dduranovic97/HID-Foot-Mouse/Pictures/Rottary encoder with LED on.jpg

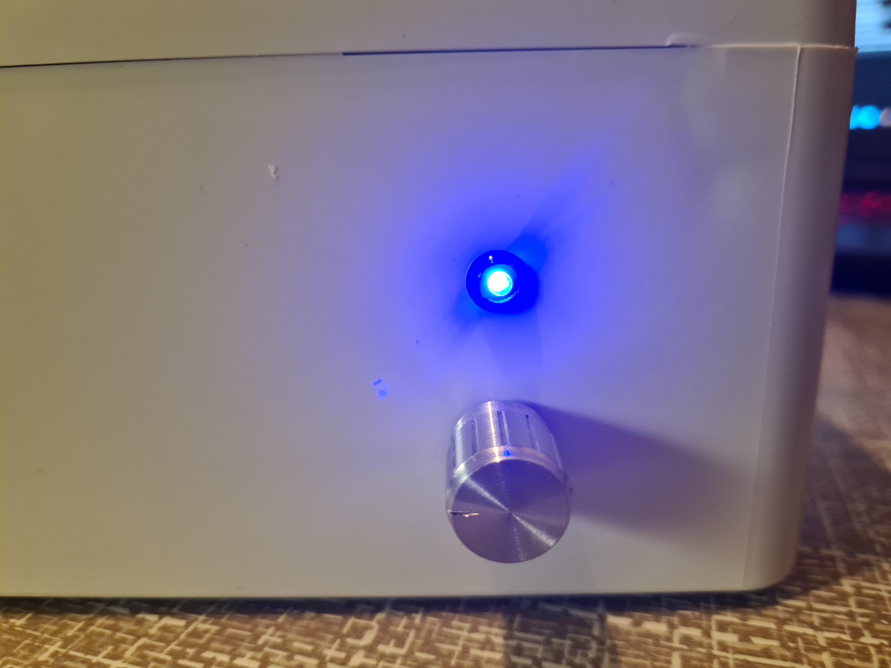
Pictures/Rottary encoder with LED on.jpg
