dduranovic97/HID-Foot-Mouse/Pictures/Rottary encoder for mouse speed control.jpg

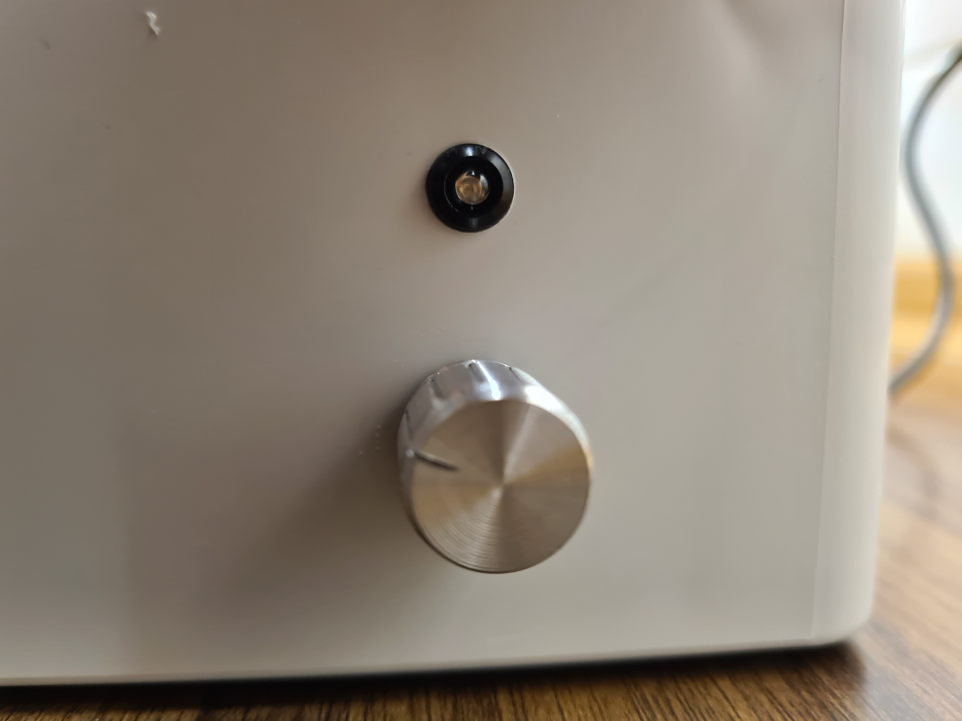
Pictures/Rottary encoder for mouse speed control.jpg
