dduranovic97/HID-Foot-Mouse/Pictures/Finished device.jpg

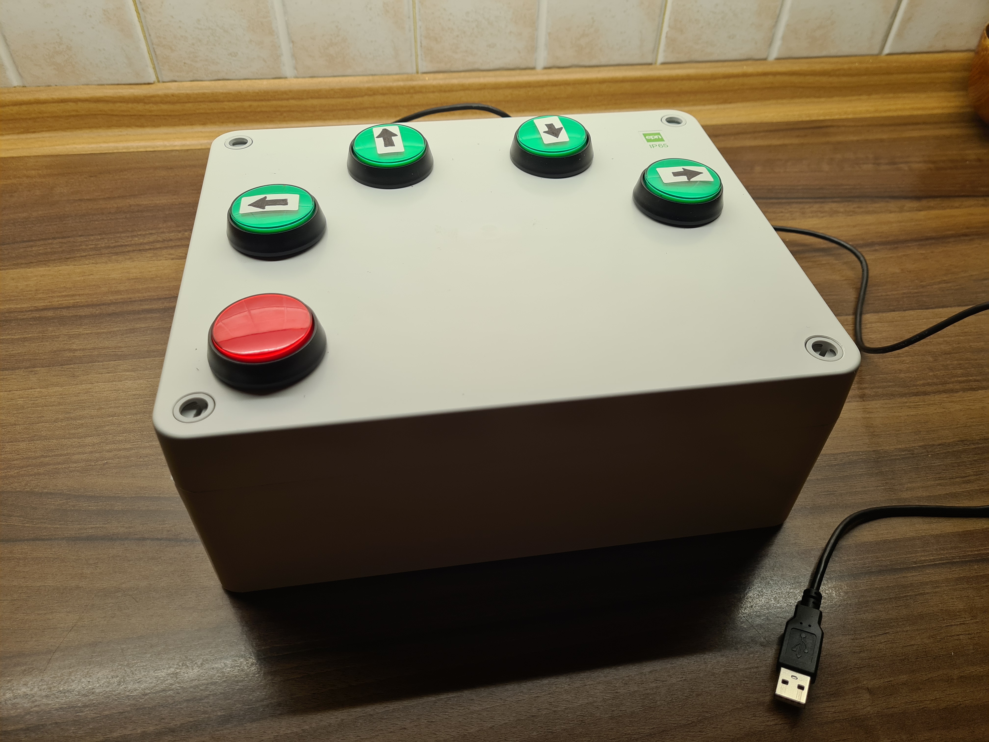
Pictures/Finished device.jpg
