dduranovic97/HID-Foot-Mouse/Pictures/Inside view.jpg

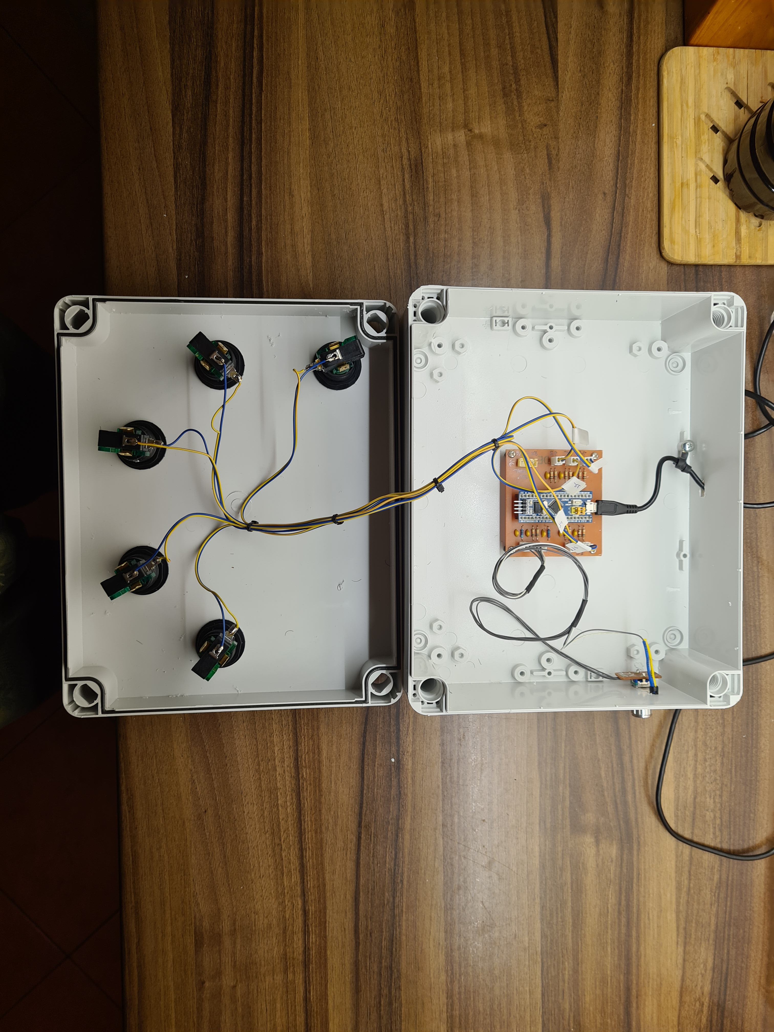
Pictures/Inside view.jpg
