dduranovic97/HID-Foot-Mouse/Pictures/Top View.jpg

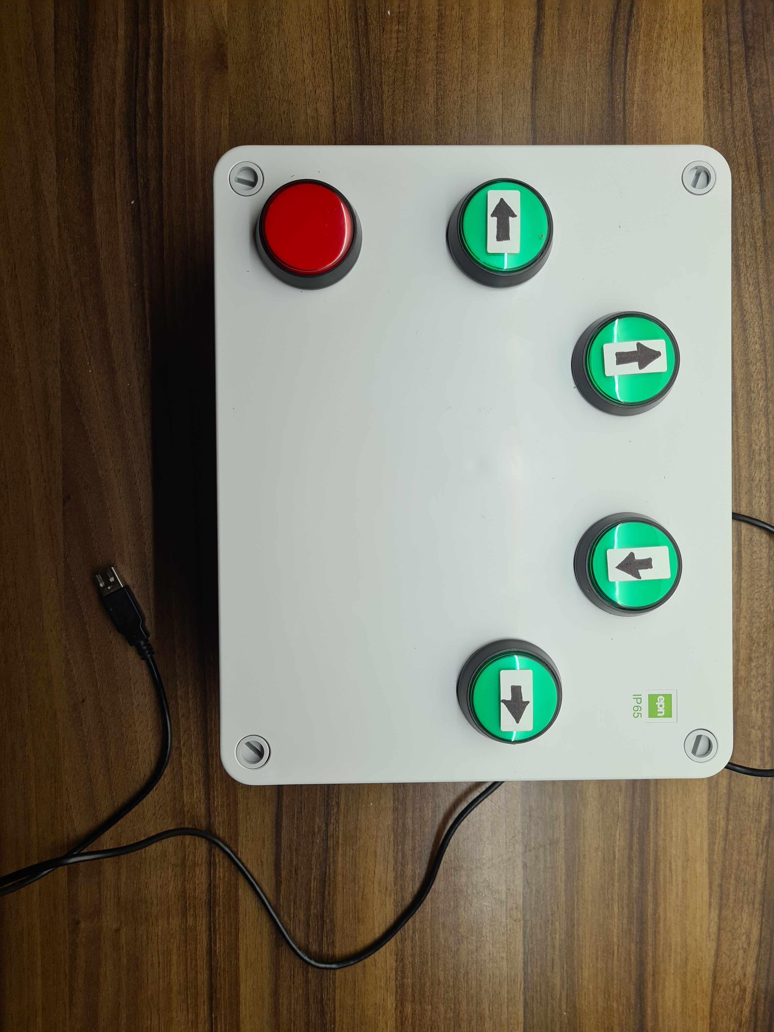
Pictures/Top View.jpg
