dduranovic97/HID-Foot-Mouse/(list of files, cad)

Other CAD files:
Housing/Foot Mouse Housing.FCStd
Housing/Foot Mouse Housing.dxf
