dduranovic97/HID-Foot-Mouse/PCB/v2/Foot_Mouse_Schematic.pdf

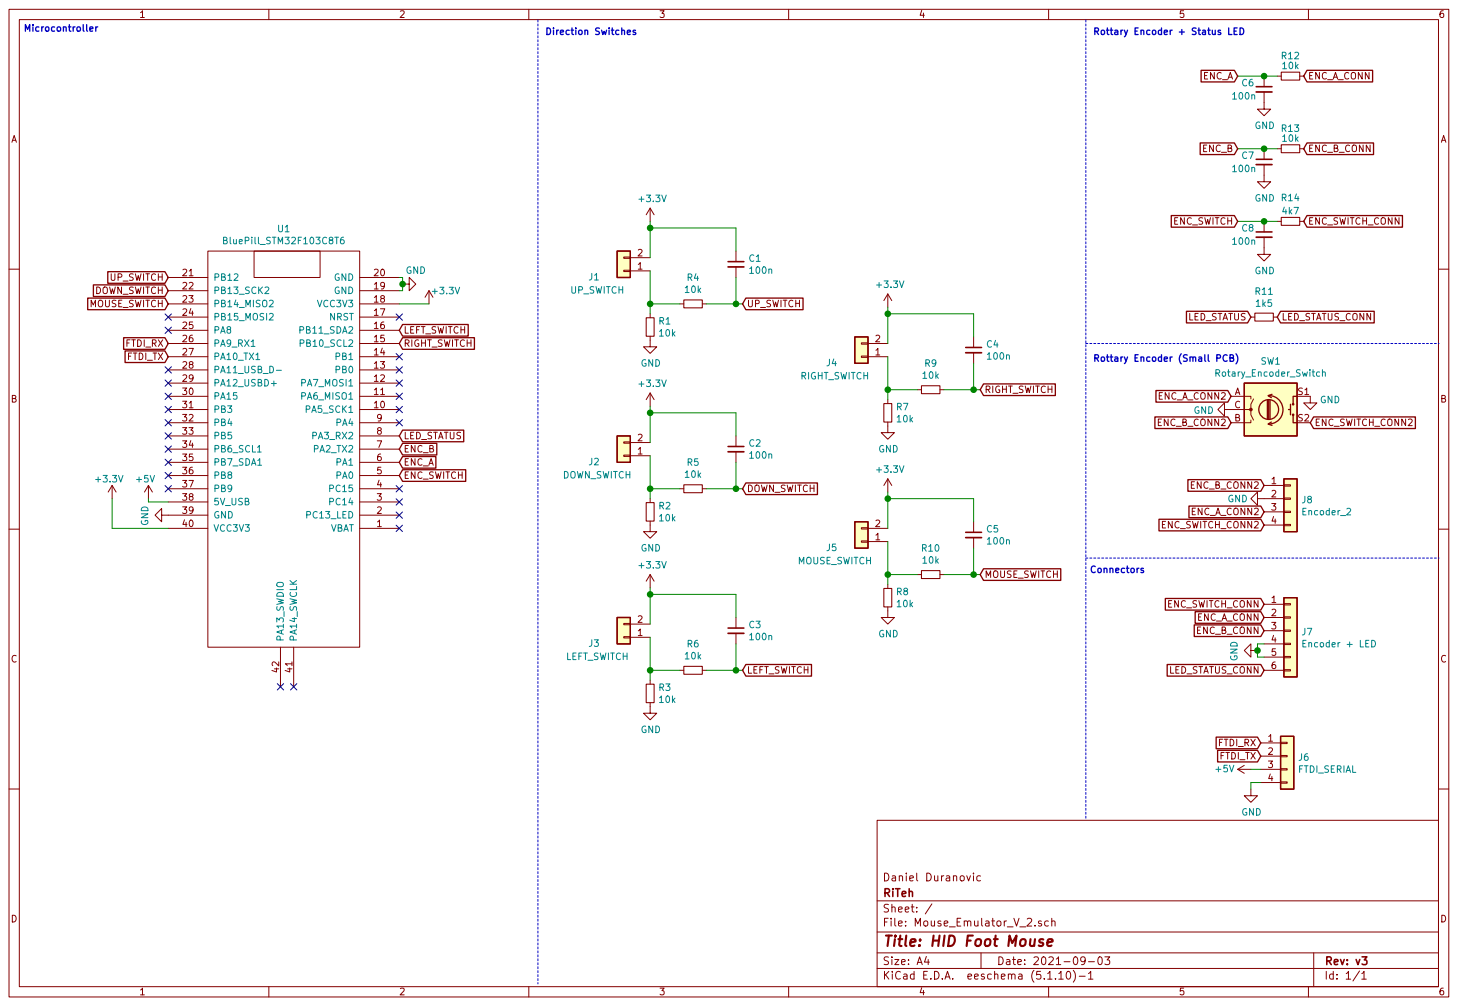
[picture p6: page 1]

File: Mouse_Emulator_V_2.sch Sheet: / RiTeh Daniel Duranovic GND

Id: 1/1 Title: HID Foot Mouse
