dduranovic97/HID-Foot-Mouse/Housing/Foot Mouse Housing.pdf

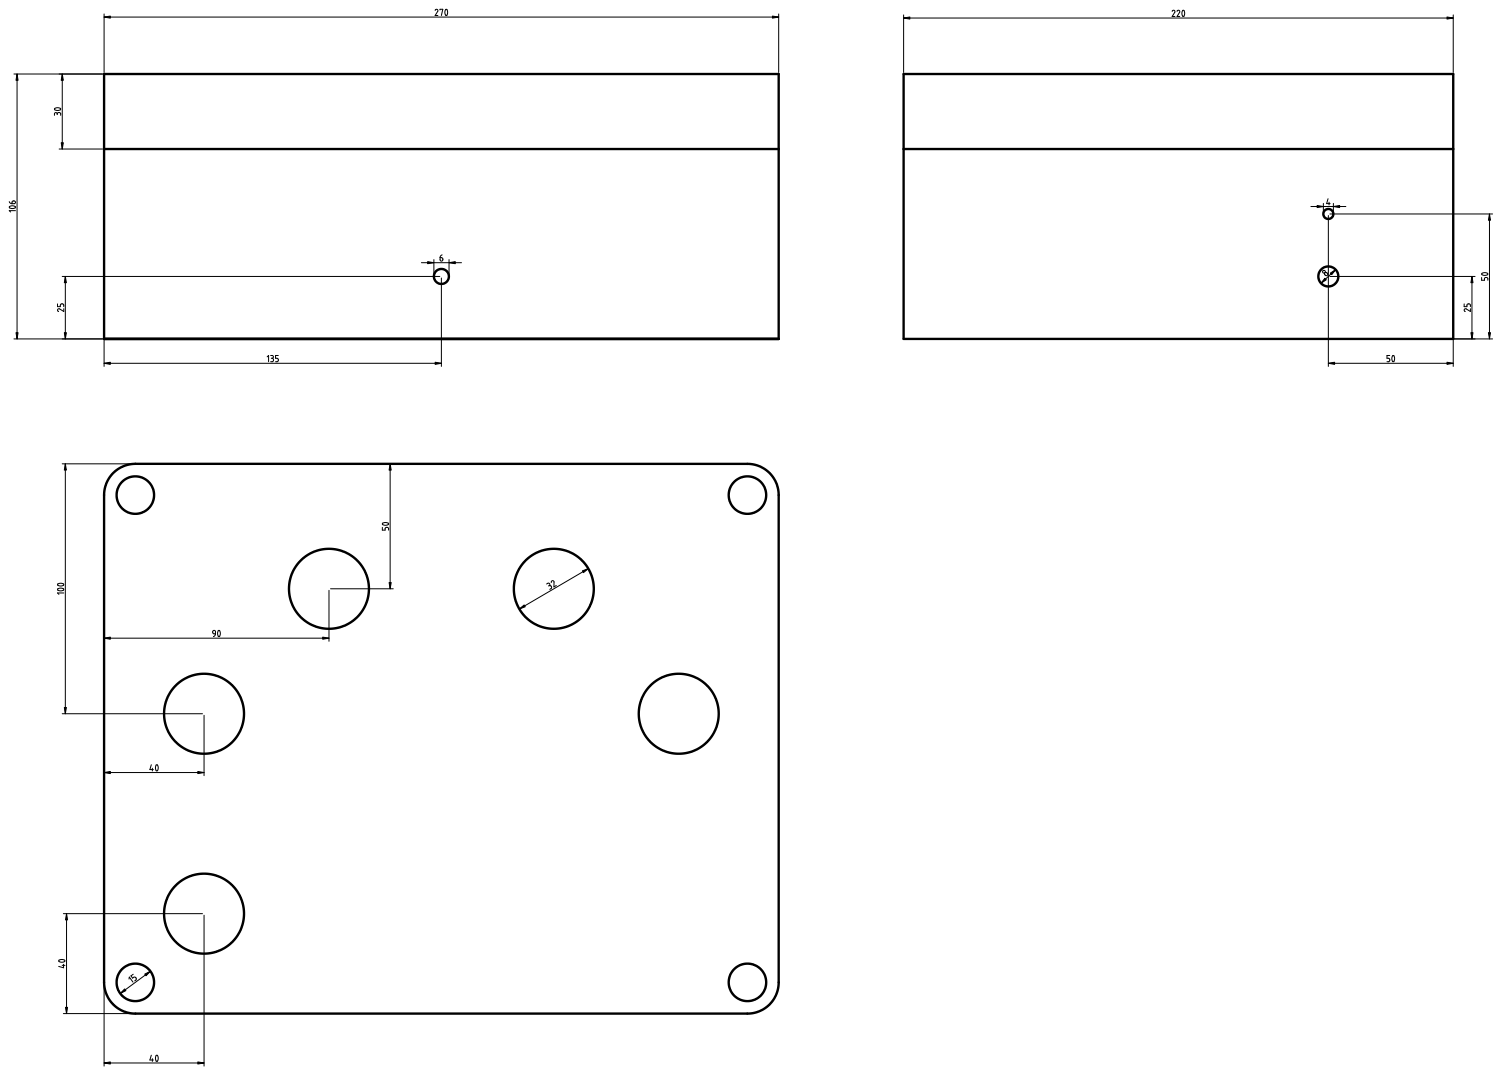
[picture p7: page 1]
