dduranovic97/HID-Foot-Mouse/PCB/v2/Foot_Mouse_PCB_Mounting.pdf

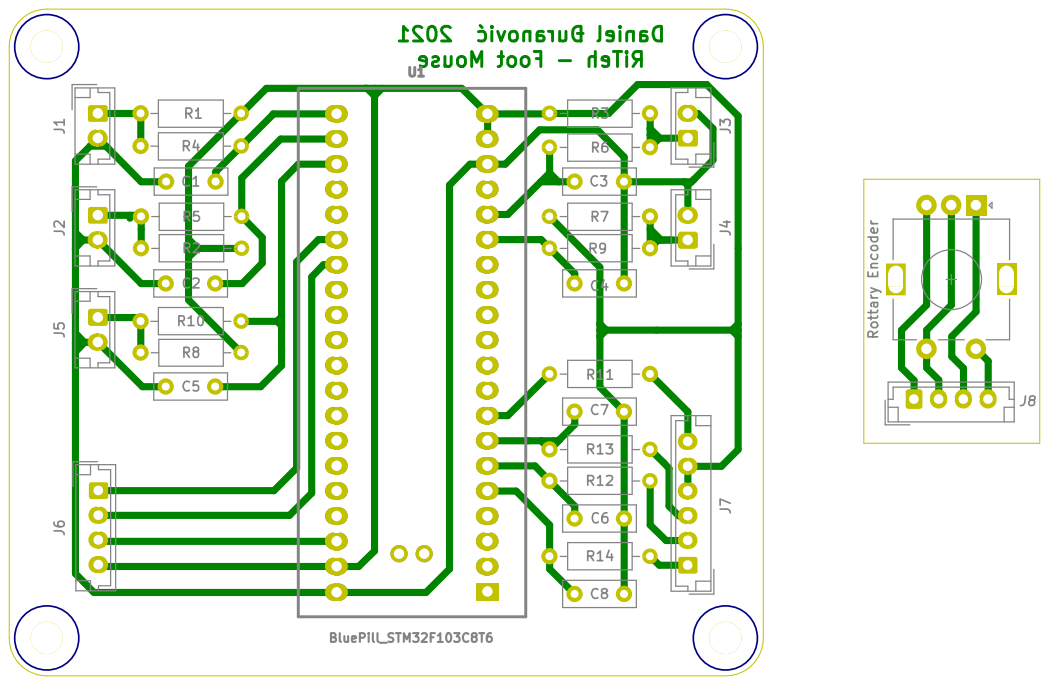
[picture p8: page 1]
