dduranovic97/HID-Foot-Mouse/PCB/v2/Foot_Mouse_PCB_Traces.pdf

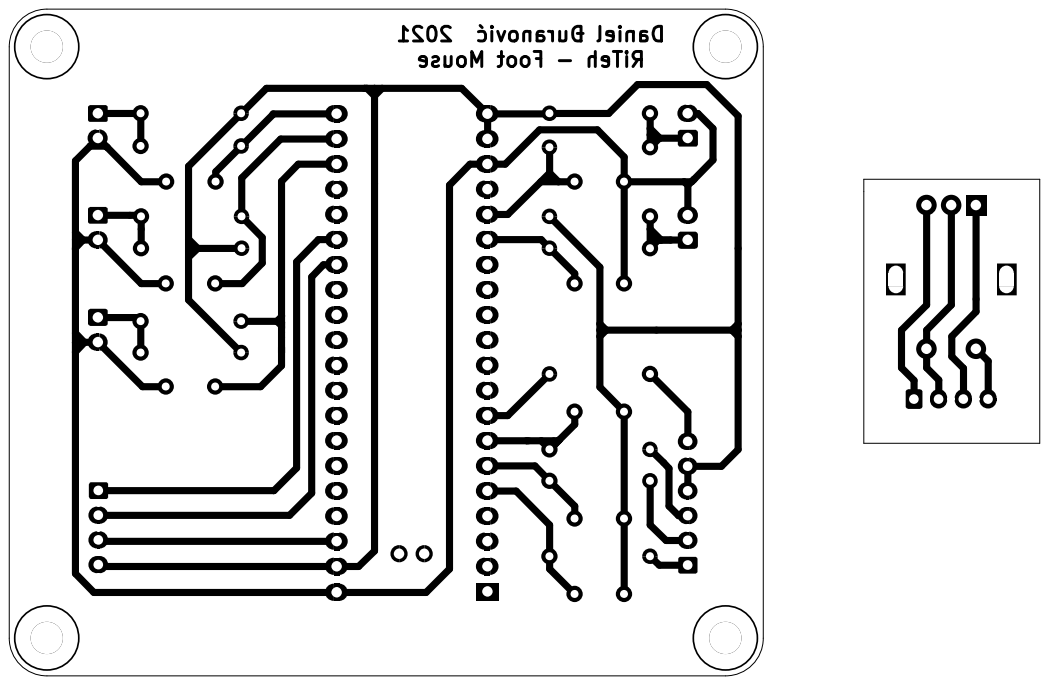
[picture p9: page 1]
