dduranovic97/HID-Foot-Mouse/(list of files, drawings)

Other design files:
PCB/v1/mouse.lay6
