dduranovic97/HID-Foot-Mouse/PCB/v2/KiCad Files/Mouse_Emulator_V_2.kicad_pcb

## KiCad design PCB/v2/KiCad Files/Mouse_Emulator_V_2.kicad_pcb (2021-09-05)

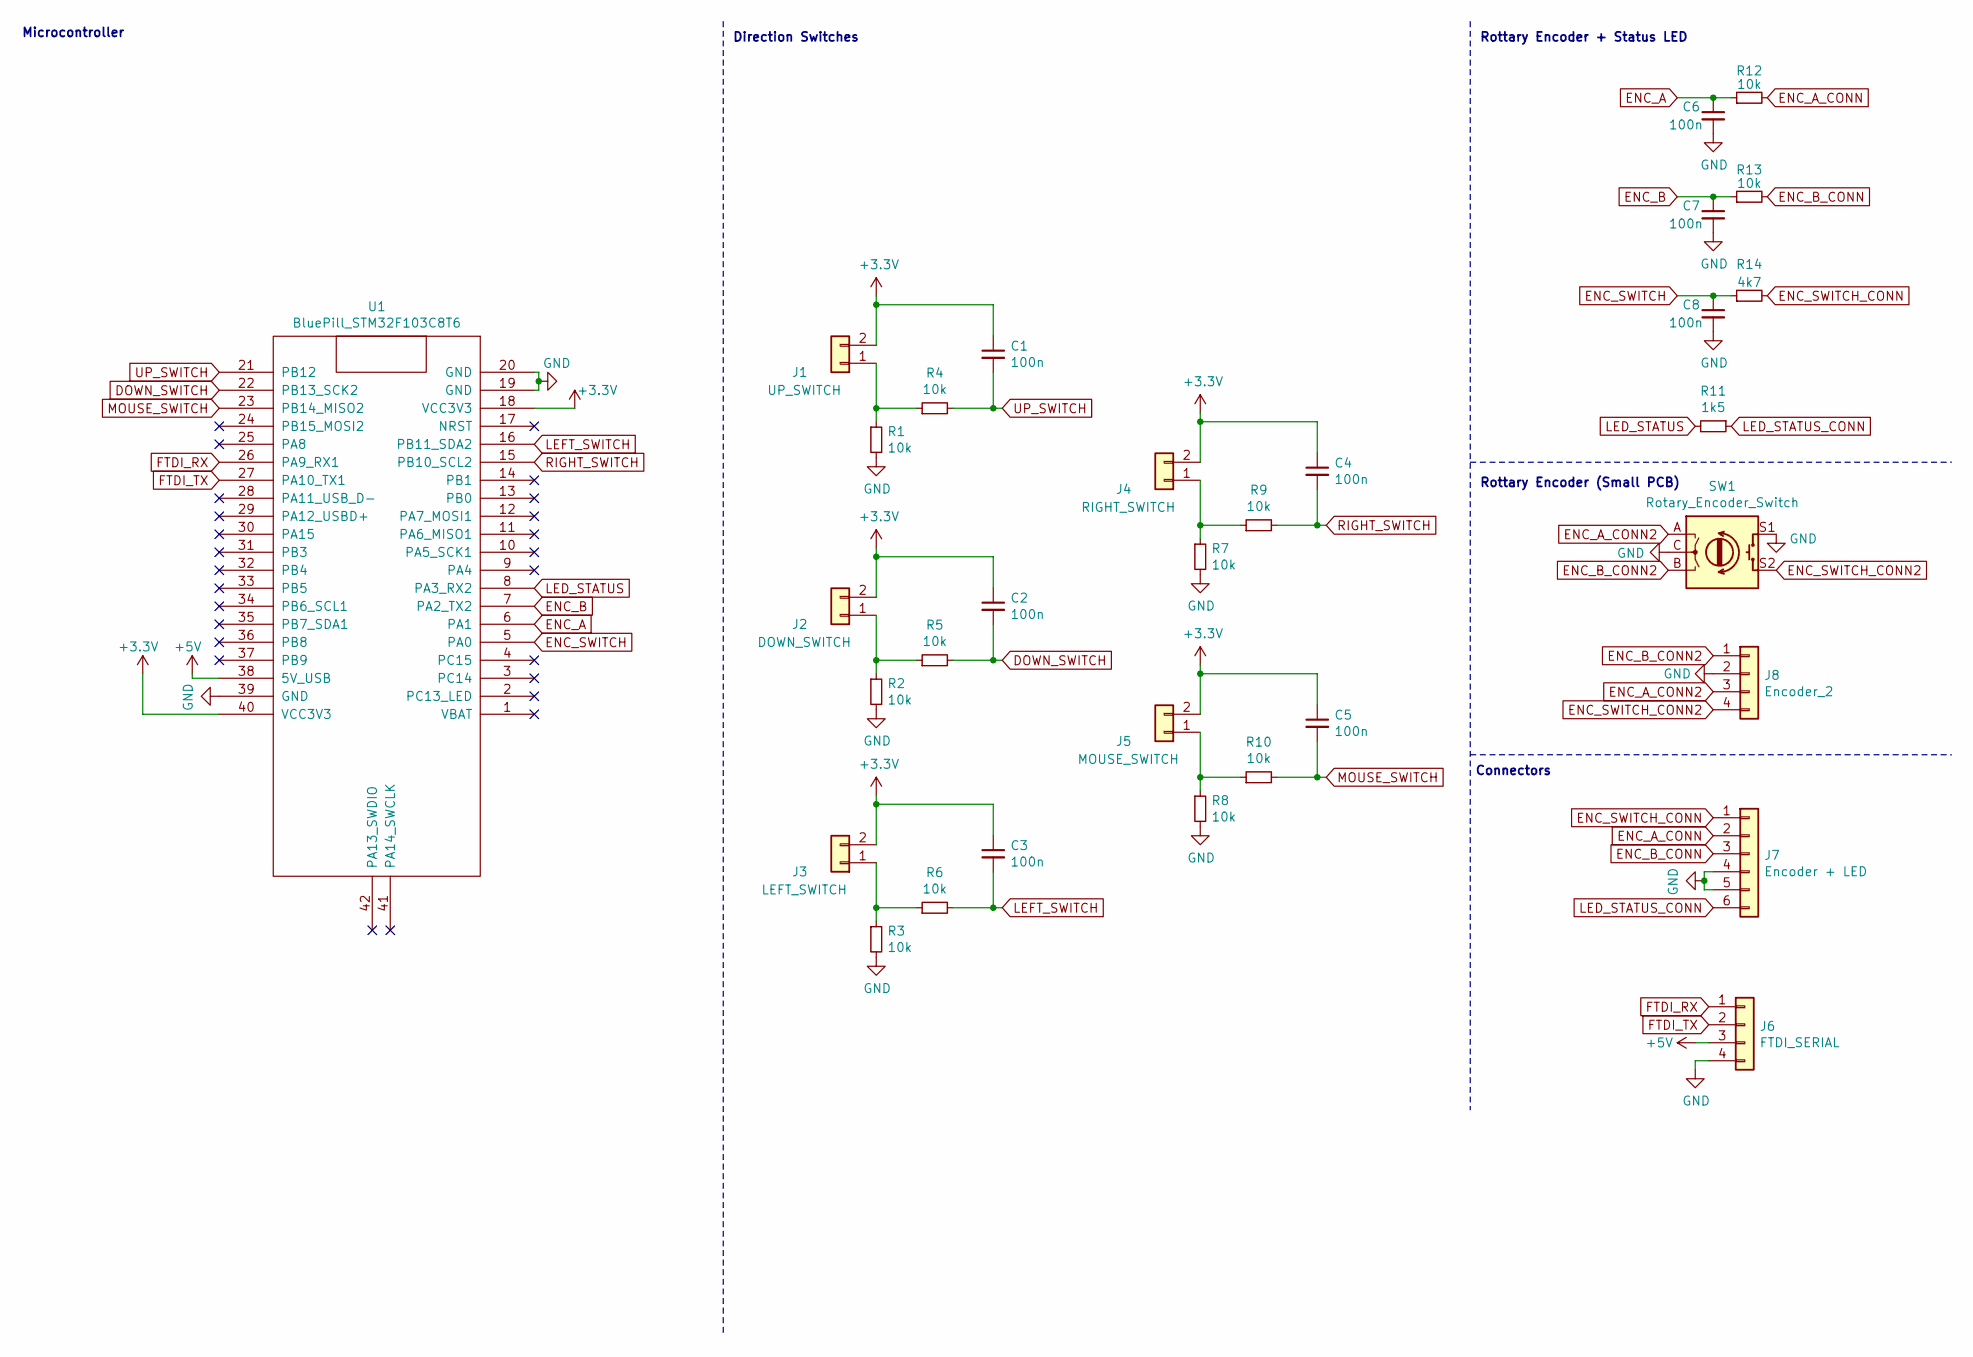
[picture p10: schematic Mouse_Emulator_V_2.sch, HID Foot Mouse]

Parts:
C1, C2, C3, C4, C5, C6, C7, C8: 100n; C_Rect_L7.2mm_W2.5mm_P5.00mm_FKS2_FKP2_MKS2_MKP2
J1: UP_SWITCH; JST_EH_B2B-EH-A_1x02_P2.50mm_Vertical
J2: DOWN_SWITCH; JST_EH_B2B-EH-A_1x02_P2.50mm_Vertical
J3: LEFT_SWITCH; JST_EH_B2B-EH-A_1x02_P2.50mm_Vertical
J4: RIGHT_SWITCH; JST_EH_B2B-EH-A_1x02_P2.50mm_Vertical
J5: MOUSE_SWITCH; JST_EH_B2B-EH-A_1x02_P2.50mm_Vertical
J6: FTDI_SERIAL; JST_EH_B4B-EH-A_1x04_P2.50mm_Vertical
J7: Encoder + LED; JST_EH_B6B-EH-A_1x06_P2.50mm_Vertical
J8: Encoder_2; JST_EH_B4B-EH-A_1x04_P2.50mm_Vertical
R1, R2, R3, R4, R5, R6, R7, R8, R9, R10, R12, R13: 10k; R_Axial_DIN0207_L6.3mm_D2.5mm_P10.16mm_Horizontal
R11: 1k5; R_Axial_DIN0207_L6.3mm_D2.5mm_P10.16mm_Horizontal
R14: 4k7; R_Axial_DIN0207_L6.3mm_D2.5mm_P10.16mm_Horizontal
SW1: Rotary_Encoder_Switch; RotaryEncoder_Alps_EC11E-Switch_Vertical_H20mm
U1: BluePill_STM32F103C8T6; BluePill_STM32F103C

Connections:
+3V3: C1.1, C2.1, C3.1, C4.1, C5.1, J1.2, J2.2, J3.2, J4.2, J5.2, U1.18 (VCC3V3), U1.40 (VCC3V3)
+5V: J6.3, U1.38 (5V_USB)
DOWN_SWITCH: C2.2, R5.2, U1.22 (PB13_SCK2)
ENC_A: C6.1, R12.1, U1.6 (PA1)
ENC_A_CONN: J7.2, R12.2
ENC_A_CONN2: J8.3, SW1.A; also elsewhere on the board
ENC_B: C7.1, R13.1, U1.7 (PA2_TX2)
ENC_B_CONN: J7.3, R13.2
ENC_B_CONN2: J8.1, SW1.B; also elsewhere on the board
ENC_SWITCH: C8.1, R14.1, U1.5 (PA0)
ENC_SWITCH_CONN: J7.1, R14.2
ENC_SWITCH_CONN2: J8.4, SW1.S2; also elsewhere on the board
FTDI_RX: J6.1, U1.26 (PA9_RX1)
FTDI_TX: J6.2, U1.27 (PA10_TX1)
GND: C6.2, C7.2, C8.2, J6.4, J7.4, J7.5, J8.2, R1.2, R2.2, R3.2, R7.2, R8.2, SW1.C, SW1.S1, U1.19 (GND), U1.20 (GND), U1.39 (GND); also elsewhere on the board
LED_STATUS: R11.2, U1.8 (PA3_RX2)
LED_STATUS_CONN: J7.6, R11.1
LEFT_SWITCH: C3.2, R6.2, U1.16 (PB11_SDA2)
MOUSE_SWITCH: C5.2, R10.2, U1.23 (PB14_MISO2)
unnamed: J1.1, R1.1, R4.1
unnamed: J2.1, R2.1, R5.1
unnamed: J3.1, R3.1, R6.1
unnamed: J4.1, R7.1, R9.1
unnamed: J5.1, R8.1, R10.1
RIGHT_SWITCH: C4.2, R9.2, U1.15 (PB10_SCL2)
UP_SWITCH: C1.2, R4.2, U1.21 (PB12)

Notes on the sheet:
Microcontroller
Direction Switches
Rottary Encoder + Status LED
Connectors
Rottary Encoder (Small PCB)

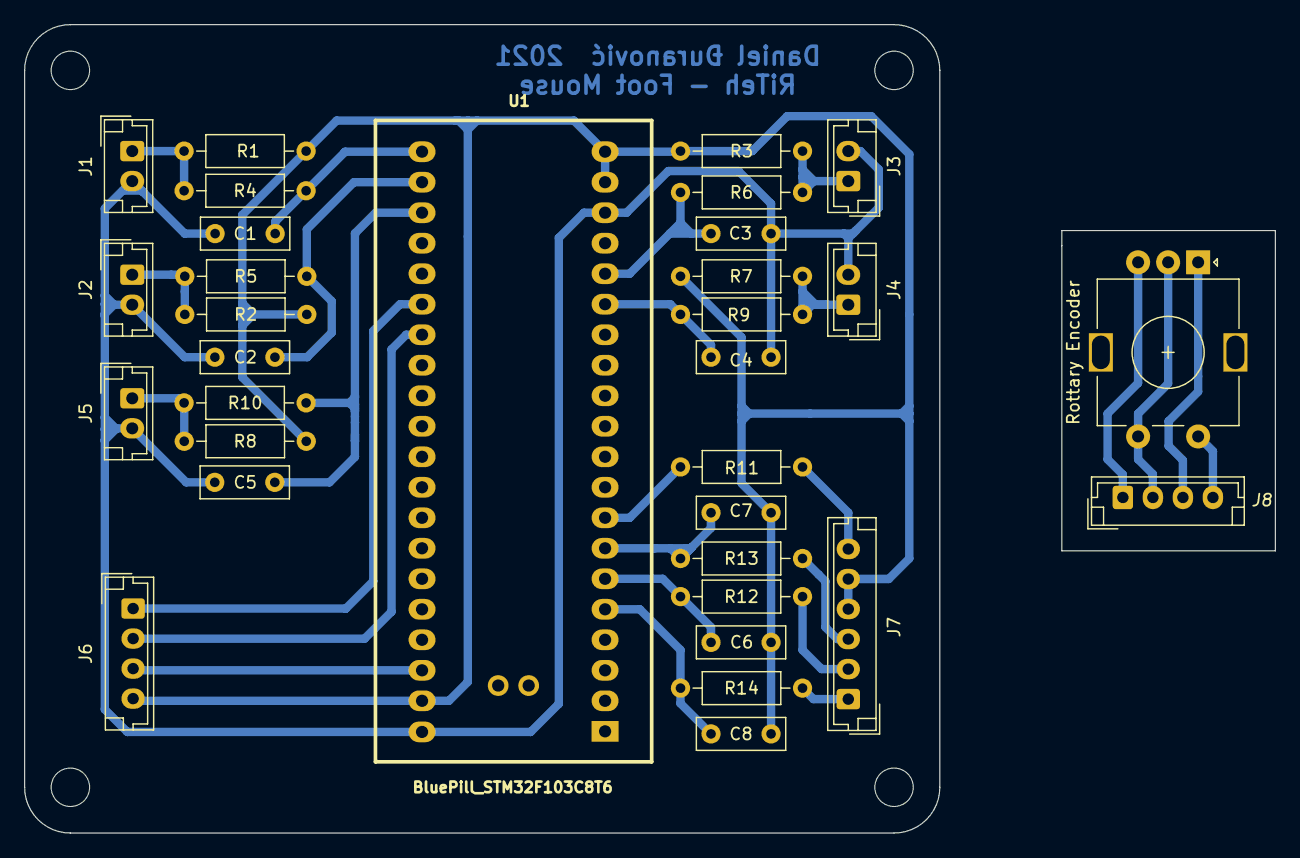
[picture p11: board Mouse_Emulator_V_2.kicad_pcb from above]

Board: 2 copper layers, 76.2 x 67.3 mm, 32 parts (0 on the bottom side), 26 nets.

Other parts of the board:
Rottary Encoder: Rotary_Encoder_Switch; RotaryEncoder_Alps_EC11E-Switch_Vertical_H20mm

Their connections:
ENC_A_CONN2: Rottary Encoder.A; also elsewhere on the board
ENC_B_CONN2: Rottary Encoder.B; also elsewhere on the board
ENC_SWITCH_CONN2: Rottary Encoder.S2; also elsewhere on the board
GND: Rottary Encoder.C, Rottary Encoder.S1; also elsewhere on the board
