dduranovic97/HID-Foot-Mouse/(commit log)

2021-08-25 First Commit
    Problem kod softwarea - Windows ga odjednom ne prepoznaje kao HID uređaj ("Device Mulfunctioned in past")
    [Mouse_Emulator_V_2.sch, mouse.lay6]
2021-09-02 Fixed encoder
2021-09-03 Fixed counter and trigering interupt
    Fixed counter incrementing to max value, corected counter values, added map() function to mouseRange, the interupt doesn't trigger anymore when board is plugged in USB Port
    [HID_Mouse_Emulator.ino]
2021-09-03 Schematic V2
    [Mouse_Emulator_V_2.sch]
2021-09-03 Pins definition + Schematic
    [Mouse_Emulator_V_2.sch]
2021-09-05 Big Commit
    Pins definition, schematic, PCB layout, Box Dimensions, pictures and so on.
    [Foot Mouse Housing.FCStd, Foot Mouse Housing.dxf, Mouse_Emulator_V_2.kicad_pcb, Mouse_Emulator_V_2.sch]
